iu3qez/myplanck/output/outlines/board.dxf

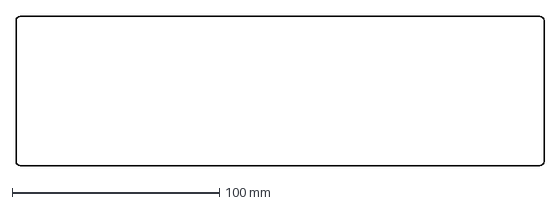
[picture p1: CAD file, 2026-03-06]
output/outlines/board.dxf
255.0 x 72.0 mm
