iu3qez/myplanck/output/outlines/keycaps.dxf

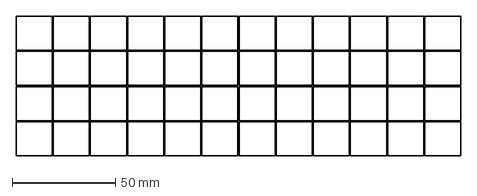
[picture p2: CAD file, 2026-03-02]
output/outlines/keycaps.dxf
215.5 x 67.5 mm
