iu3qez/myplanck/output/pcbs/p48v2.kicad_pcb

## KiCad design output/pcbs/p48v2.kicad_pcb (2026-03-09)

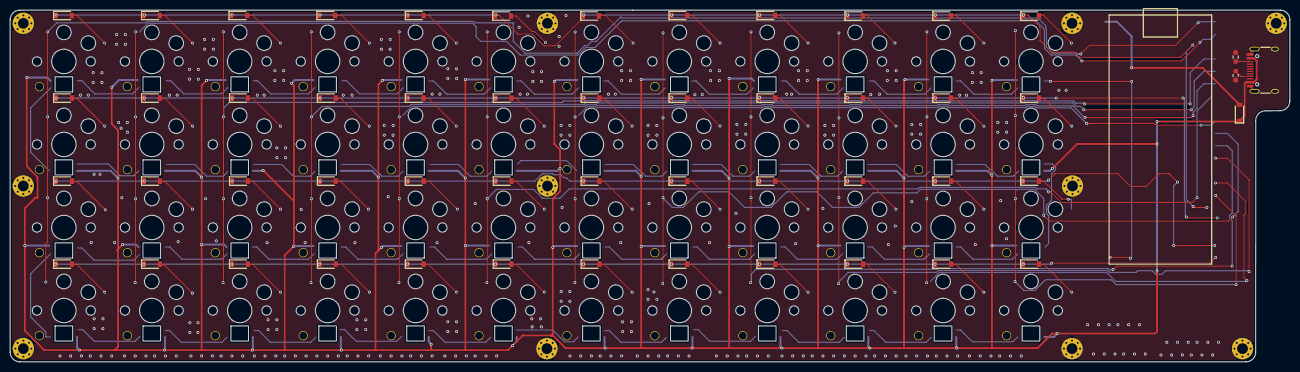
[picture p3: board p48v2.kicad_pcb from above]

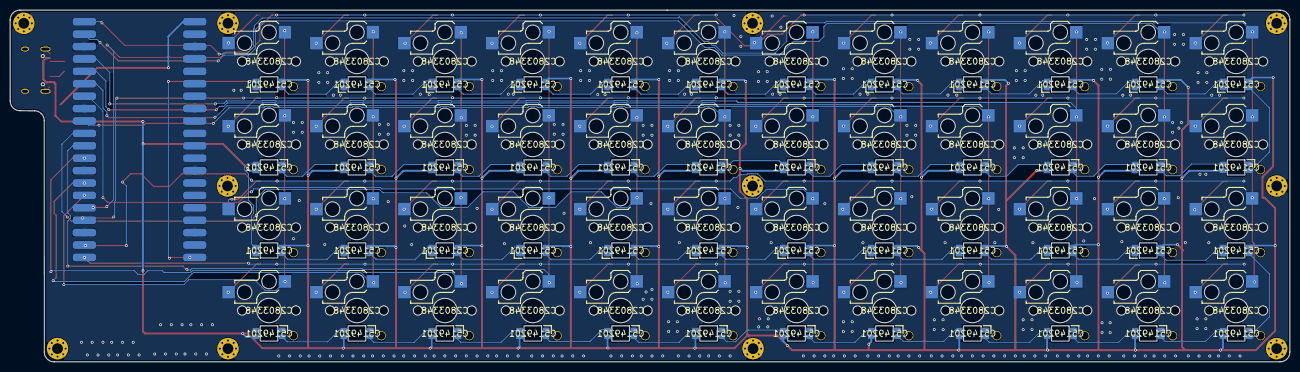
[picture p4: board p48v2.kicad_pcb from below]

Board: 2 copper layers, 262.0 x 72.0 mm, 160 parts (96 on the bottom side), 117 nets.

Parts:
19.051: pico
D1, D2, D3, D4, D5, D6, D7, D8, D9, D10, D11, D12, D13, D14, D15, D16, D17, D18, D19, D20, D21, D22, D23, D24, D25, D26, D27, D28, D29, D30, D31, D32, D33, D34, D35, D36, D37, D38, D39, D40, D41, D42, D43, D44, D45, D46, D47, D48, D49: diode_tht_sod123
H1, H2, H3, H4, H5, H6, H7, H8, H9, H10, H11: mountingholem2
J1: usb_c_hro_type_c_31_m_12
LED1, LED2, LED3, LED4, LED5, LED6, LED7, LED8, LED9, LED10, LED11, LED12, LED13, LED14, LED15, LED16, LED17, LED18, LED19, LED20, LED21, LED22, LED23, LED24, LED25, LED26, LED27, LED28, LED29, LED30, LED31, LED32, LED33, LED34, LED35, LED36, LED37, LED38, LED39, LED40, LED41, LED42, LED43, LED44, LED45, LED46, LED47, LED48: led_SK6812mini-e (per-keysingle-side)
R1, R2: resistor_0603
S1, S2, S3, S4, S5, S6, S7, S8, S9, S10, S11, S12, S13, S14, S15, S16, S17, S18, S19, S20, S21, S22, S23, S24, S25, S26, S27, S28, S29, S30, S31, S32, S33, S34, S35, S36, S37, S38, S39, S40, S41, S42, S43, S44, S45, S46, S47, S48: switch_choc_v1_v2

Connections:
COL0: 19.051.1, S1.1, S2.1, S3.1, S4.1
COL1: 19.051.2, S5.1, S6.1, S7.1, S8.1
COL2: 19.051.4, S9.1, S10.1, S11.1, S12.1
COL3: 19.051.5, S13.1, S14.1, S15.1, S16.1
COL4: 19.051.6, S17.1, S18.1, S19.1, S20.1
COL5: 19.051.7, S21.1, S22.1, S23.1, S24.1
COL6: 19.051.9, S25.1, S26.1, S27.1, S28.1
COL7: 19.051.10, S29.1, S30.1, S31.1, S32.1
COL8: 19.051.11, S33.1, S34.1, S35.1, S36.1
COL9: 19.051.12, S37.1, S38.1, S39.1, S40.1
COL10: 19.051.14, S41.1, S42.1, S43.1, S44.1
COL11: 19.051.15, S45.1, S46.1, S47.1, S48.1
CR_0_0: D4.2, S4.2
CR_0_1: D3.2, S3.2
CR_0_2: D2.2, S2.2
CR_0_3: D1.2, S1.2
CR_1_0: D8.2, S8.2
CR_1_1: D7.2, S7.2
CR_1_2: D6.2, S6.2
CR_1_3: D5.2, S5.2
CR_2_0: D12.2, S12.2
CR_2_1: D11.2, S11.2
CR_2_2: D10.2, S10.2
CR_2_3: D9.2, S9.2
CR_3_0: D16.2, S16.2
CR_3_1: D15.2, S15.2
CR_3_2: D14.2, S14.2
CR_3_3: D13.2, S13.2
CR_4_0: D20.2, S20.2
CR_4_1: D19.2, S19.2
CR_4_2: D18.2, S18.2
CR_4_3: D17.2, S17.2
CR_5_0: D24.2, S24.2
CR_5_1: D23.2, S23.2
CR_5_2: D22.2, S22.2
CR_5_3: D21.2, S21.2
CR_6_0: D28.2, S28.2
CR_6_1: D27.2, S27.2
CR_6_2: D26.2, S26.2
CR_6_3: D25.2, S25.2
CR_7_0: D32.2, S32.2
CR_7_1: D31.2, S31.2
CR_7_2: D30.2, S30.2
CR_7_3: D29.2, S29.2
CR_8_0: D36.2, S36.2
CR_8_1: D35.2, S35.2
CR_8_2: D34.2, S34.2
CR_8_3: D33.2, S33.2
CR_9_0: D40.2, S40.2
CR_9_1: D39.2, S39.2
CR_9_2: D38.2, S38.2
CR_9_3: D37.2, S37.2
CR_10_0: D44.2, S44.2
CR_10_1: D43.2, S43.2
CR_10_2: D42.2, S42.2
CR_10_3: D41.2, S41.2
CR_11_0: D48.2, S48.2
CR_11_1: D47.2, S47.2
CR_11_2: D46.2, S46.2
CR_11_3: D45.2, S45.2
GND: 19.051.3, 19.051.8, 19.051.13, 19.051.18, 19.051.23, 19.051.28, 19.051.33, 19.051.38, H1.1, H2.1, H3.1, H4.1, H5.1, H6.1, H7.1, H8.1, H9.1, H10.1, H11.1, J1.A1, J1.A12, J1.B1, J1.B12, J1.S1, LED1.3, LED2.3, LED3.3, LED4.3, LED5.3, LED6.3, LED7.3, LED8.3, LED9.3, LED10.3, LED11.3, LED12.3, LED13.3, LED14.3, LED15.3, LED16.3, LED17.3, LED18.3, LED19.3, LED20.3, LED21.3, LED22.3, LED23.3, LED24.3, LED25.3, LED26.3, LED27.3, LED28.3, LED29.3, LED30.3, LED31.3, LED32.3, LED33.3, LED34.3, LED35.3, LED36.3, LED37.3, LED38.3, LED39.3, LED40.3, LED41.3, LED42.3, LED43.3, LED44.3, LED45.3, LED46.3, LED47.3, LED48.3, R1.2, R2.2
LED0: 19.051.21, LED48.4
LED1: LED44.4, LED48.2
LED2: LED40.4, LED44.2
LED3: LED36.4, LED40.2
LED4: LED32.4, LED36.2
LED5: LED28.4, LED32.2
LED6: LED24.4, LED28.2
LED7: LED20.4, LED24.2
LED8: LED16.4, LED20.2
LED9: LED12.4, LED16.2
LED10: LED8.4, LED12.2
LED11: LED4.4, LED8.2
LED12: LED3.4, LED4.2
LED13: LED3.2, LED7.4
LED14: LED7.2, LED11.4
LED15: LED11.2, LED15.4
LED16: LED15.2, LED19.4
LED17: LED19.2, LED23.4
LED18: LED23.2, LED27.4
LED19: LED27.2, LED31.4
LED20: LED31.2, LED35.4
LED21: LED35.2, LED39.4
LED22: LED39.2, LED43.4
LED23: LED43.2, LED47.4
LED24: LED46.4, LED47.2
LED25: LED42.4, LED46.2
LED26: LED38.4, LED42.2
LED27: LED34.4, LED38.2
LED28: LED30.4, LED34.2
LED29: LED26.4, LED30.2
LED30: LED22.4, LED26.2
LED31: LED18.4, LED22.2
LED32: LED14.4, LED18.2
LED33: LED10.4, LED14.2
LED34: LED6.4, LED10.2
LED35: LED2.4, LED6.2
LED36: LED1.4, LED2.2
LED37: LED1.2, LED5.4
LED38: LED5.2, LED9.4
LED39: LED9.2, LED13.4
LED40: LED13.2, LED17.4
LED41: LED17.2, LED21.4
LED42: LED21.2, LED25.4
LED43: LED25.2, LED29.4
LED44: LED29.2, LED33.4
LED45: LED33.2, LED37.4
LED46: LED37.2, LED41.4
LED47: LED41.2, LED45.4
ROW0: 19.051.16, D4.1, D8.1, D12.1, D16.1, D20.1, D24.1, D28.1, D32.1, D36.1, D40.1, D44.1, D48.1
ROW1: 19.051.17, D3.1, D7.1, D11.1, D15.1, D19.1, D23.1, D27.1, D31.1, D35.1, D39.1, D43.1, D47.1
ROW2: 19.051.19, D2.1, D6.1, D10.1, D14.1, D18.1, D22.1, D26.1, D30.1, D34.1, D38.1, D42.1, D46.1
ROW3: 19.051.20, D1.1, D5.1, D9.1, D13.1, D17.1, D21.1, D25.1, D29.1, D33.1, D37.1, D41.1, D45.1
USB2_CC1: J1.A5, R1.1
USB2_CC2: J1.B5, R2.1
VBUS: 19.051.40, D49.2
VCC: D49.1, J1.A4, J1.A9, J1.B4, J1.B9, LED1.1, LED2.1, LED3.1, LED4.1, LED5.1, LED6.1, LED7.1, LED8.1, LED9.1, LED10.1, LED11.1, LED12.1, LED13.1, LED14.1, LED15.1, LED16.1, LED17.1, LED18.1, LED19.1, LED20.1, LED21.1, LED22.1, LED23.1, LED24.1, LED25.1, LED26.1, LED27.1, LED28.1, LED29.1, LED30.1, LED31.1, LED32.1, LED33.1, LED34.1, LED35.1, LED36.1, LED37.1, LED38.1, LED39.1, LED40.1, LED41.1, LED42.1, LED43.1, LED44.1, LED45.1, LED46.1, LED47.1, LED48.1
