iu3qez/myplanck/(commit log)

2026-03-02 Initial commit: Planck 4x12 custom keyboard PCB
    Ergogen config for 4x12 ortholinear matrix with Choc v1/v2 hotswap,
    per-key SK6812mini-e RGB LEDs, Raspberry Pi Pico 2, SSD1306 OLED,
    EC11 rotary encoder. Includes KiCad PCB with manual edits
    (component placement, net assignments, GND zones).
    [board.dxf, keycaps.dxf, p48v2.kicad_pcb]
2026-03-02 Add design doc: replace OLED breakout with bare 1.3" SSD1306 FPC panel
    Adafruit module PCB protrudes too much for low-profile Choc switches.
    Bare panel (1.45mm) + FPC ZIF connector + ~9 passives on PCB instead.
2026-03-02 Add implementation plan: OLED bare panel FPC integration
    6 tasks: remove U2, add nets, place FPC connector + passives,
    verify layout, update docs.
2026-03-03 Remove Adafruit SSD1306 module (U2) from PCB
    [p48v2.kicad_pcb]
2026-03-03 Add OLED internal nets for FPC bare panel circuit
2026-03-03 Place FPC connector J1 and OLED passives (C1-C6, R1-R3) on F.Cu
    J1: Hirose FH12-30S-0.5SH 30-pin FPC ZIF at (333, -19)
    - All 30 pins + 2 MP pads with net assignments for I2C mode
    - BS0/BS1/BS2=GND (I2C), D/C=GND (addr 0x3C)
    - D0=I2C_SCL, D1+D2=I2C_SDA
    Passives clustered around J1:
    - C1,C2: 1uF charge pump caps (C1P/C1N, C2P/C2N)
    - C3: 4.7uF VCOMH bypass, C4: 2.2uF VBAT bypass
    - C5,C6: 100nF VDD/VCC decoupling
    - R1: 910k IREF, R2,R3: 4.7k I2C pull-ups
    Placed via direct S-expression editing (MCP place_component
    couldn't find footprints from standard KiCad libraries).
    [p48v2.kicad_pcb]
2026-03-03 Update docs: OLED changed from breakout module to bare FPC panel
    - Replace U2 entry with J1 FPC connector + C1-C6/R1-R3 passives
    - Add newly discovered MCP limitations (find_component freeze,
    add_net not persisting, export_svg silent failure)
    - Add no co-author commit rule
2026-03-03 Add USB-C power input for LED 5V (J2, R4, R5, D49)
    J2: HRO TYPE-C-31-M-12 (C165948) power-only USB-C connector
    R4, R5: 5.1k CC1/CC2 pulldowns for USB-C negotiation
    D49: B5819W Schottky for backfeed protection on Pico VBUS
    Circuit: external 5V via J2 feeds VCC (LED rail) directly,
    Pico VBUS feeds VCC through Schottky D49 to prevent backfeed.
    Components at temporary position, to be moved in pcbnew.
    [p48v2.kicad_pcb]
2026-03-03 Rebuild board outline with USB-C extension and filleted corners
    Extension tab (332→343, -87→-97.5) below main board for USB-C
    power connector J2. All 6 corners with r=2 fillet including
    concave inner corner at (332,-87) near Pico pin 1.
    [p48v2.kicad_pcb]
2026-03-04 Fix diode-hotswap interference, add Pico and mounting holes to ergogen
    - Move diodes from B.Cu to F.Cu, shift from [0,-8.5] to [0,9.5] (above switch)
    - Rewrite diode footprint with standard SOD-123 fab outline and courtyard
    - Add Pico THT footprint (from AlexSutila/ergogen-footprints, KiCad 8)
    - Add M2 mounting hole footprints (hole + mounting with via ring)
    - Add Pico to config with full net mapping (COL0-11, ROW0-3, LED, encoder, I2C)
    - Add 11 M2 mounting holes (4 corners, 3 mid-edge, 2 center, 2 extension)
    - Regenerate PCB from updated ergogen config
    [board.dxf, keycaps.dxf, p48v2.kicad_pcb]
2026-03-06 Add USB-C power footprint, 0603 resistor, and Pico castellated option
    New ergogen footprints:
    - usb_c_hro_type_c_31_m_12.js: HRO TYPE-C-31-M-12 USB-C receptacle
    - resistor_0603.js: 0603 HandSolder SMD resistor
    Pico footprint now supports castellated mounting (SMD pads at board edge)
    via castellated: true param. Config updated to use castellated on B.Cu.
    Config additions: J2 (USB-C power), R4/R5 (CC pulldowns), D49 (Schottky)
    [board.dxf, keycaps.dxf, p48v2.kicad_pcb]
2026-03-06 Enlarge Pico castellated pads, add Power netclass 1.0mm track
    Pico castellated pads: 4.8x1.6mm at board edge with 50% more exposed area.
    Power netclass: 1.0mm track, 0.3mm clearance, 0.8/0.4mm via.
    Assigned VCC, VBUS, GND, VSYS, OUT_3V3, VCC_3V3 to Power class.
    [p48v2.kicad_pcb]
2026-03-06 Manual KiCad edits: routing and board setup
    [p48v2.kicad_pcb]
2026-03-08 feat: reorder LED chain to zigzag pattern with row-specific rotation
    - Change from serpentine to top-right descending zigzag
    - Alternate rotation per row for proper zig-zag spacing
    - Add LCSC C5149201 part number to all SK6812mini-e LEDs
    - Split LED footprint config by row for rotation control
2026-03-09 Save PCB state (locked - no more ergogen regeneration)
    [p48v2.kicad_pcb]
